gejanssen/Xiaomi-Scooter-Motion-Control/(commit log)

2021-09-10 Add files via upload
    Add files - libraries for arduino
2021-09-10 Update README.md
    Updated images for arduino
2021-09-10 V 3.2 ws2812 for feedback of gass throttle
    V 3.2 includes ws2812 for feedback of gass throttle
